Franck78/Chiplab/chiplab.pdf

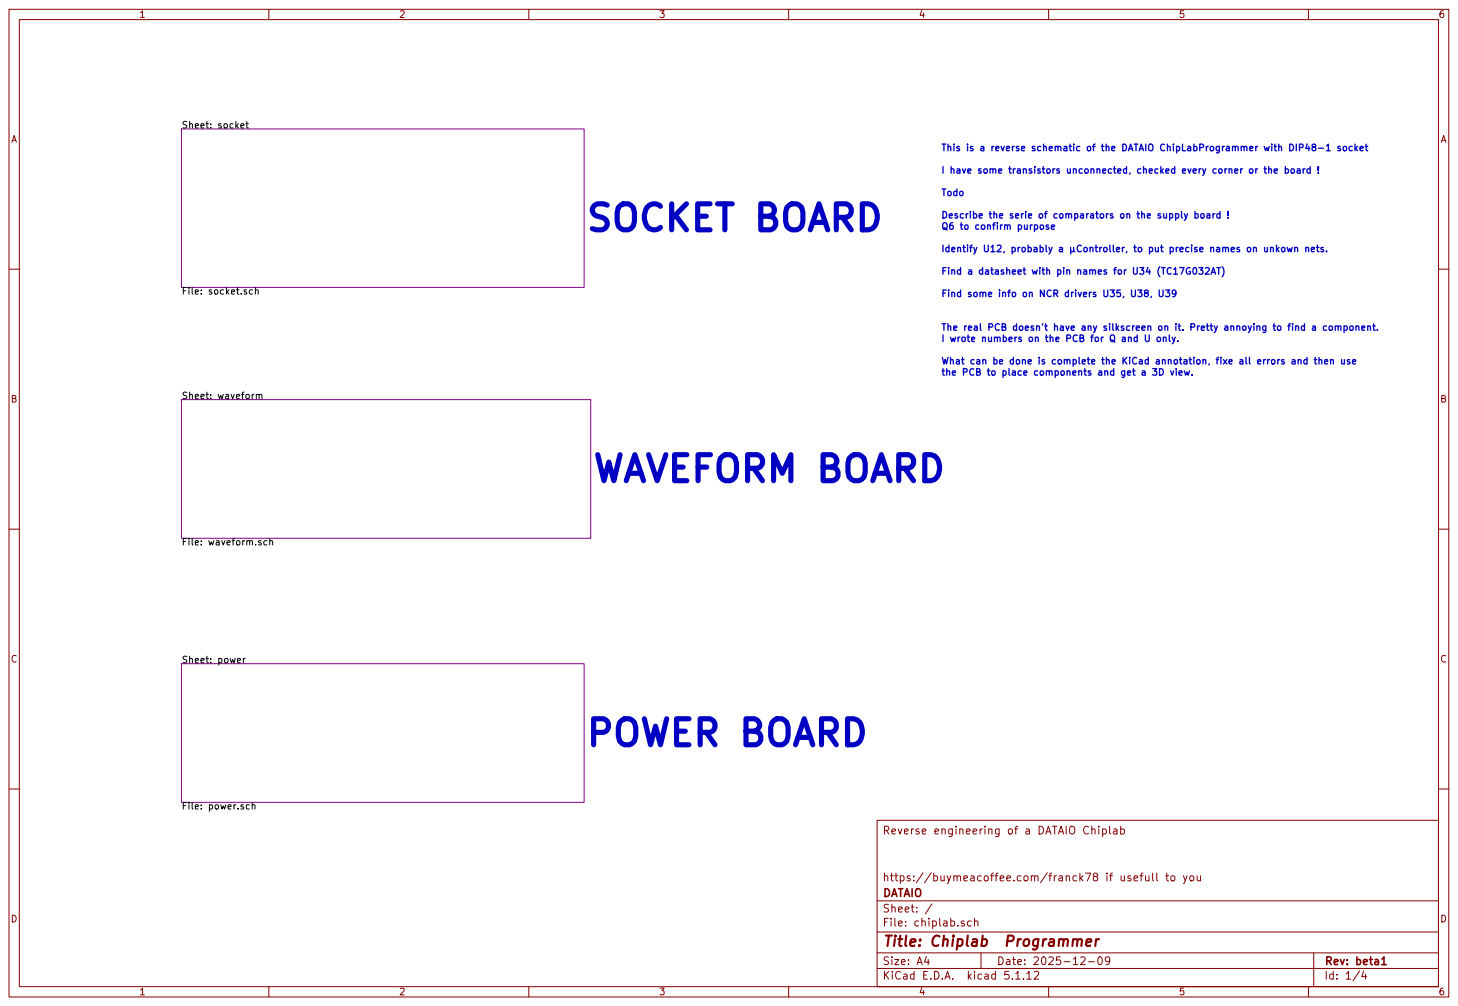
[picture p1: page 1]

Sheet: socket File: socket.sch Sheet: waveform

This is a reverse schematic of the DATAIO ChipLabProgrammer with DIP48-1 socket

I have some transistors unconnected, checked every corner or the board ! Todo Describe the serie of comparators on the supply board !

Identify U12, probably a µController, to put precise names on unkown nets.

Find a datasheet with pin names for U34 (TC17G032AT)

Find some info on NCR drivers U35, U38, U39

The real PCB doesn't have any silkscreen on it. Pretty annoying to find a component.
I wrote numbers on the PCB for Q and U only.

What can be done is complete the KiCad annotation, fixe all errors and then use
the PCB to place components and get a 3D view.

File: waveform.sch Sheet: power

Reverse engineering of a DATAIO Chiplab

https://buymeacoffee.com/franck78 if usefull to you
File: chiplab.sch Sheet: / DATAIO

Id: 1/4 Title: Chiplab Programmer

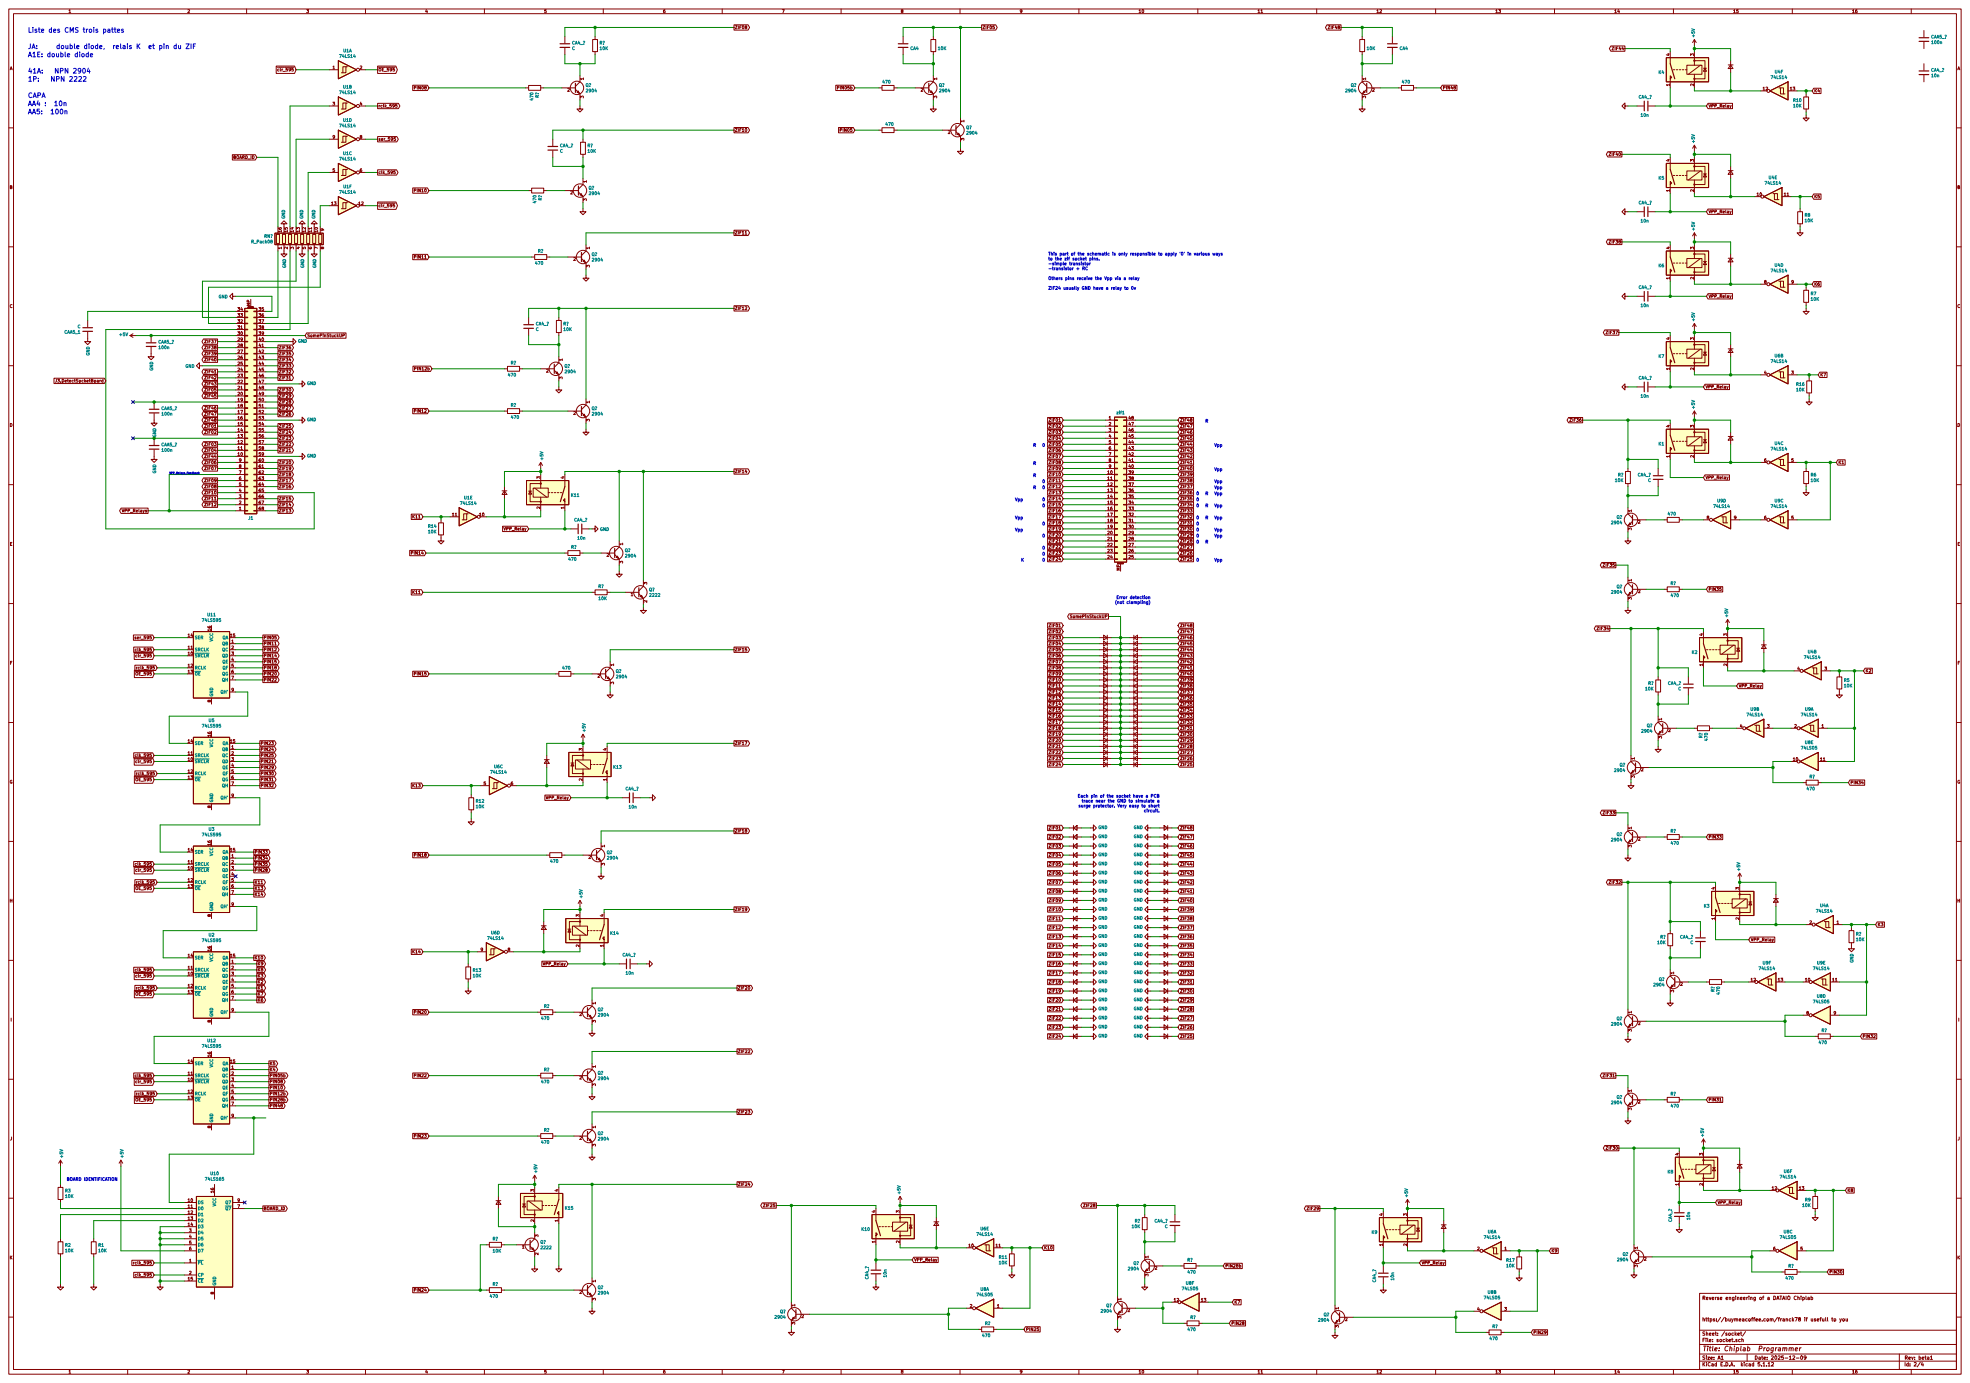
[picture p2: page 2]

Liste des CMS trois pattes

JA: double diode, relais K et pin du ZIF
A1E: double diode

This part of the schematic is only responsible to apply '0' in various ways
to the zif socket pins.
-simple transistor
-transistor + RC Others pins receive the Vpp via a relay

ZIF24 usually GND have a relay to 0v

74LS14 GND GND GND GND GND GND

surge protector. Very easy to short circuit. K

ZIF27
ZIF26
GND GND GND GND GND GND GND

Each pin of the socket have a PCB
trace near the GND to simulate a

Reverse engineering of a DATAIO Chiplab

Id: 2/4 Title: Chiplab Programmer File: socket.sch Sheet: /socket/ https://buymeacoffee.com/franck78 if usefull to you

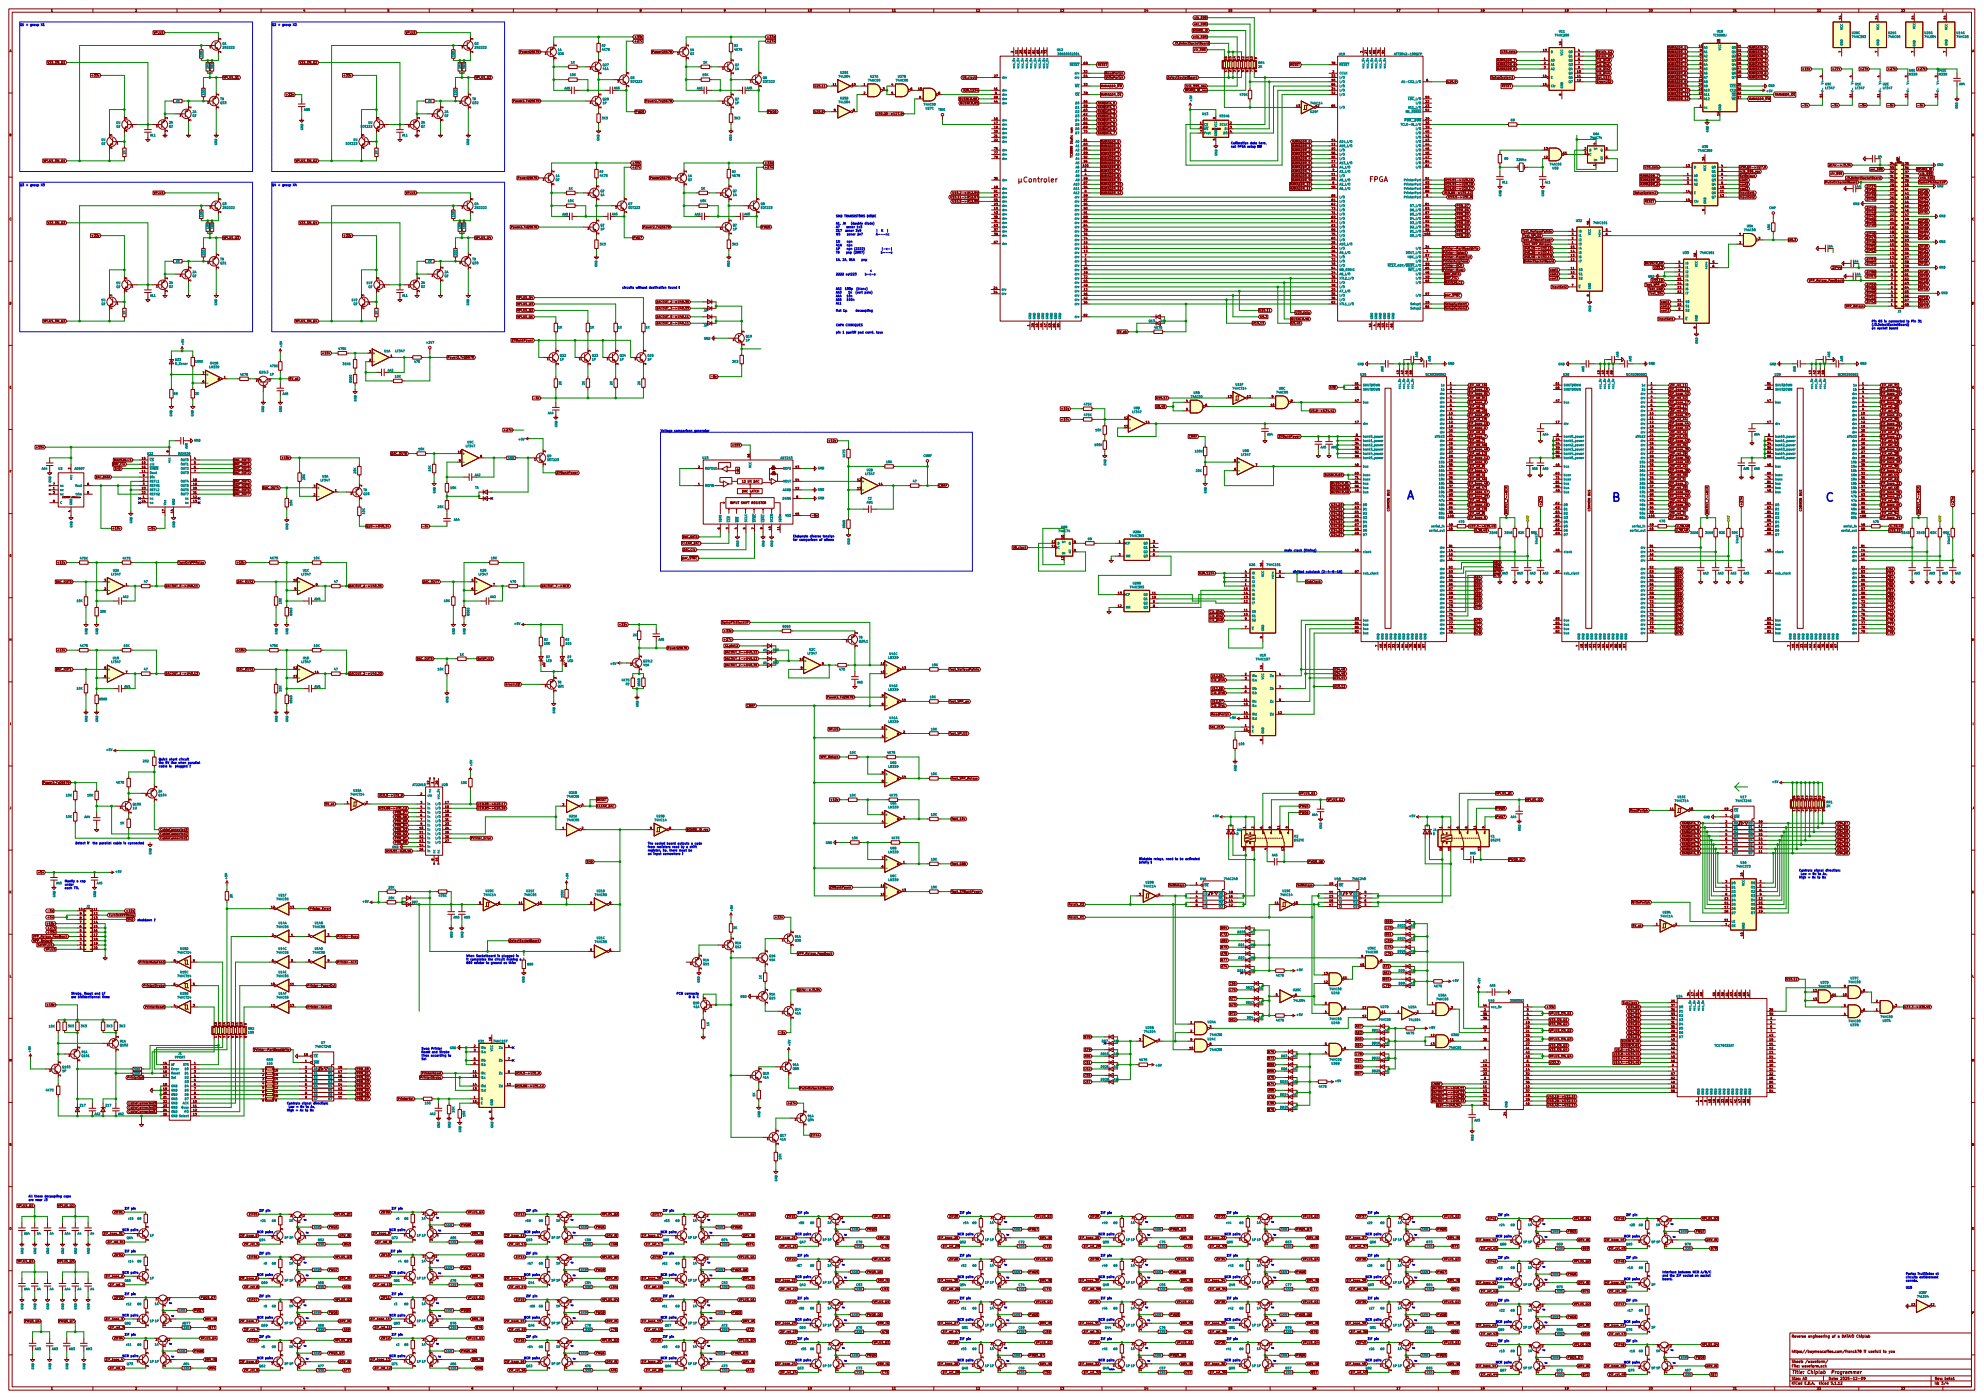
[picture p3: page 3]

Calibration data here, not FPGA setup !!!!

circuits without destination found !

flat 1µ decoupling CAPA CHIMIQUES

Pin 65 is connected to Pin 31
(J3.DetectSocketBoard) on socket board

pin 1 positif pad carré, tous

Elaborate diverse tension
for comparison of others

Quick short circuit
the 5V line when parallel
cable is plugged ?

Detect if the parallel cable is connected

The socket board outputs a code
from resistors read by a shift
register. So, there must be
an input somewhere !

Bistable relays, need to be activated
briefly !

Controls signal direction;
Low = Bx to Ax, High = Ax to Bx

When Socketboard is plugged in
it completes the circuit making a
660 reistor to ground as this:

Strobe, Reset and LF
are bididectionnal lines

Swap Printer Reset and Strobe

lines according to Sel

All these decoupling caps
are near J3

Interface between NCR A/B/C
and the ZIF socket on socket board.

Portes inutilisées et circuits entièrement sonnés. U15

Id: 3/4 Title: Chiplab Programmer File: waveform.sch Sheet: /waveform/ https://buymeacoffee.com/franck78 if usefull to you

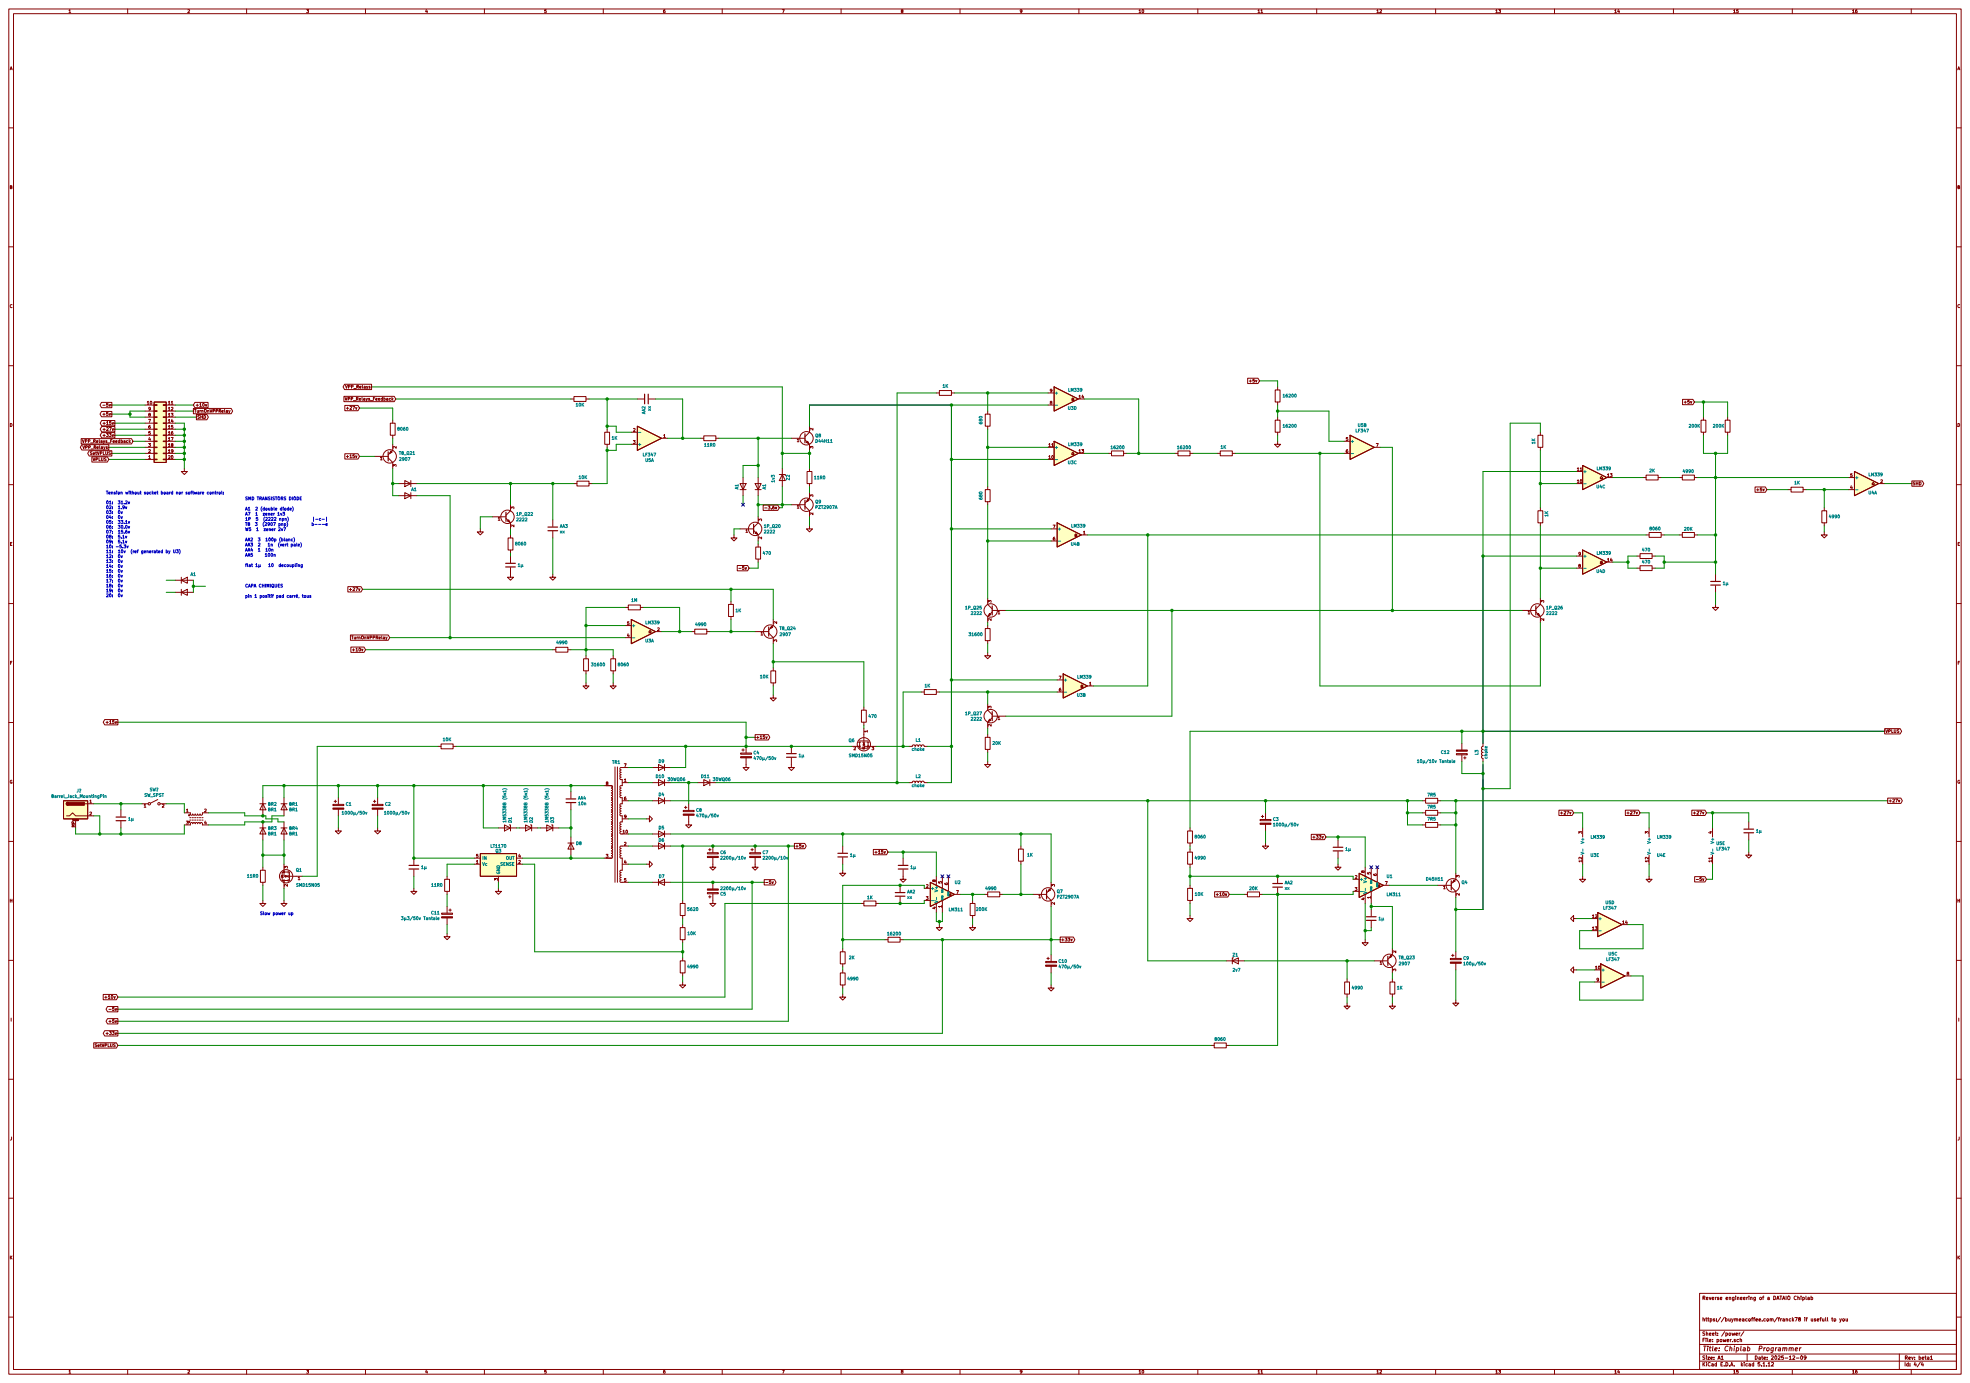
[picture p4: page 4]

Tension without socket board nor software control: 01: 31.2v 02: 1.9v 03: 0v 04: 0v 05: 33.1v 06: 30.0v 07: 15.6v 08: 5.1v 09: 5.1v 10: -5.3v 11: 10v (ref generated by U3) 12: 0v 13: 0v 14: 0v 15: 0v 16: 0v 17: 0v 18: 0v 19: 0v 20: 0v

SMD TRANSISTORS DIODE A1 2 (double diode) A7 1 zener 1v3

flat 1µ 10 decoupling CAPA CHIMIQUES

pin 1 positif pad carré, tous

https://buymeacoffee.com/franck78 if usefull to you

Sheet: /power/
File: power.sch
Id: 4/4 Title: Chiplab Programmer
