Franck78/Chiplab/power.sch

## KiCad design power.sch (2025-12-08)

Schematic: power.sch

Parts:
1P_Q20, 1P_Q22, 1P_Q25, 1P_Q26, 1P_Q27: 2222
A1: D
AA2, AA3: xx
AA4: 10n
BR1, BR2, BR3, BR4: BR1
C1, C2, C3: 1000µ/50v
C4, C8, C10: 470µ/50v
C5, C6, C7: 2200µ/10v
C9: 100µ/50v
C11: 3µ3/50v Tantale
C12: 10µ/10v Tantale
D1, D2, D3: 1N5338B (5v1)
D4, D5, D6, D7, D8, D9: D
D10, D11: 30WQ06
L1, L2, L3: choke
Q1, Q6: SMD15N05
Q3: LT1170
Q4: D45H11
Q7, Q9: PZT2907A; SOT-223-3_TabPin2
Q8: D44H11
T8_Q21, T8_Q23, T8_Q24: 2907
TR1: TR1
U1, U2: LM311
U3, U4: LM339
U5: LF347
Z1: 2v7
Z2: 1v3

Notes on the sheet:
Tension without socket board nor software control: 01: 31.2v 02: 1.9v 03: 0v 04: 0v 05: 33.1v 06: 30.0v 07: 15.6v 08: 5.1v 09: 5.1v 10: -5.3v 11: 10v (ref generated by U3) 12: 0v 13: 0v 14: 0v 15: 0v 16: 0v 17: 0v 18: 0v 19: 0v 20: 0v
SMD TRANSISTORS DIODE A1 2 (double diode) A7 1 zener 1v3 1P 5 (2222 npn) |-c-| T8 3 (2907 pnp) b---e W5 1 zener 2v7 AA2 3 100p (blanc) AA3 2 1n (vert pale) AA4 1 10n AA5 100n flat 1µ 10 decoupling CAPA CHIMIQUES pin 1 positif pad carré, tous
Slow power up
