Franck78/Chiplab/socket.sch

## KiCad design socket.sch (2025-12-08)

Schematic: socket.sch

Parts:
CAA5_1: C
J1: Conn_02x34_Counter_Clockwise_MountingPin
K1, K2, K3, K4, K5, K6, K7, K8, K9, K10, K11, K13, K14, K15: UMS05-1A80-75D; Relay_StandexMeder_UMS
R1, R2, R3, R5, R6, R7, R8, R9, R10, R11, R12, R13, R14, R16, R17: 10K
U1, U4, U6, U9: 74LS14
U2, U3, U5, U11, U12: 74LS595
U8: 74LS05
U10: 74LS165
zif1: Conn_02x24_Counter_Clockwise_MountingPin

Notes on the sheet:
BOARD IDENTIFICATION
Each pin of the socket have a PCB trace near the GND to simulate a surge protector. Very easy to short circuit.
Liste des CMS trois pattes JA: double diode, relais K et pin du ZIF A1E: double diode 41A: NPN 2904 1P: NPN 2222 CAPA AA4 : 10n AA5: 100n
VPP_Relays_Feedback
This part of the schematic is only responsible to apply '0' in various ways to the zif socket pins. -simple transistor -transistor + RC Others pins receive the Vpp via a relay ZIF24 usually GND have a relay to 0v
Error detection (not clampling)
Vpp
