Franck78/Chiplab/waveform.sch

## KiCad design waveform.sch (2025-12-08)

Schematic: waveform.sch

Parts:
1U: Q?
A54, A55, A56, A57, A58, A59, A72, A73, A76, A77, A78, A79: 330
AB77: 330
B52, B53, B54, B55, B56, B57, B58, B59, B72, B73, B74, B75, B76, B78, B79: 330
C52, C53, C54, C55, C56, C57, C58, C59, C72, C73, C74, C75, C76, C77, C78, C79: 330
DD1, DD2, DD3, DD4, DD5, DD6, DD7, DD8, DD10, DD11, DD12, DD13, DD14, DD15, DD16, DD21, DD22, DD23, DD24, DD25, DD26, DD27, DD28, DD29, DD30: A1
DZ3: D_Zener
J1: PPORT
J2: Conn_02x10_Counter_Clockwise
J3: Conn_02x34_Counter_Clockwise_MountingPin
JA: D
K1, K2: DS2YE; Relay_DPDT_FRT5
Q1, Q2, Q3, Q4: 2N2222
Q5, Q6, Q7, Q8, Q9: SOT223
Q10, Q14, Q16, Q17, Q18, Q27, Q29.2: 41A
Q11, Q12, Q15, Q34, Q35, Q99, Q101, Q102: 91A
Q13: A1
Q19, Q22, Q23, Q24, Q25, Q28, Q29.3, Q40, Q41, Q42, Q43, Q44, Q45, Q46, Q47, Q48, Q49, Q50, Q51, Q52, Q53, Q54, Q55, Q60, Q61, Q62, Q63, Q64, Q65, Q66, Q67, Q68, Q69, Q70, Q71, Q72, Q73, Q74, Q75, Q80, Q81, Q82, Q83, Q84, Q85, Q86, Q87, Q88, Q89, Q90, Q91, Q92, Q93, Q94, Q95, Q103: 1P
Q20, Q21, Q29.1, Q30, Q31, Q32, Q33: T8
Q26: 1A
Q104: 2A
Q105: 1U
RR1, RR4: 2K
RR2, RR3: 100
U1, U2, U9: LF347
U3: AD587
U4: 74AC240
U5: 74AC00
U6: 74AC74
U7, U17: 74HCT245
U8, U41: LM339
U10, U31: 74HC157
U11, U30: 74HC259
U12: 30800002001
U13: 93S46
U14, U21: 74HC05
U15: 74HCT14
U16: 74HC373
U18: TC5588J; DIP-28_W15.24mm
U19: ATT3042-100QFP
U20: AT22V10
U22: MAX528
U23: AD7243
U24, U27, U36, U37: 74HC00
U25: 74LS04
U26, U32, U33: 74HC151
U28: 74HC393
U29: 74HC14
U34: TC17G032AT
U35, U38, U39: NCR0390582
U40: 3080092
black: 50K
r2, r3, r4, r5, r6, r8, r9, r10, r11, r12, r14, r15, r16, r17, r18, r20, r21, r22, r23, r24, r26, r27, r28, r29, r41, r42, r43, r44, r45, r46, r48, r49, r50, r51, r52, r54, r55, r56, r57, r58, r60, r61, r62, r63, r64, r66, r67, r68: 68

Notes on the sheet:
Portes inutilisées et circuits entièrement sonnés. U15
SMD TRANSISTORS DIODE A1, JA (double diode) A7 zener 1v3 Z17 zener 3v9 | K | W5 zener 2v7 A---nc 1U npn 41A npn 1P npn (2222) |-c-| T8 pnp (2907) b---e 1A, 2A, 91A pnp c 2222 sot223 b-c-e AA2 100p (blanc) AA3 1n (vert pale) AA4 10n AA5 100n AL1 flat 1µ decoupling CAPA CHIMIQUES pin 1 positif pad ca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
Controls signal direction; Low = Bx to Ax, High = Ax to Bx
NCR pairs
ZIF pin
top
bottom
Q1 + group X1
Q2 + group X2
Q3 + group X3
Q4 + group X4
Swap Printer Reset and Strobe lines according to Sel
main clock (timing)
divided subclock (2-4-8-16)
Elaborate diverse tension for comparison of others
circuits without destination found !
Bistable relays, need to be activated briefly !
Pin 65 is connected to Pin 31 (J3.DetectSocketBoard) on socket board
When Socketboard is plugged in it completes the circuit making a 660 reistor to ground as this:
PCB connects B & C
Voltage comparison generator
Strobe, Reset and LF are bididectionnal lines
Detect if the parallel cable is connected
Quick short circuit the 5V line when parallel cable is plugged ?
Interface between NCR A/B/C and the ZIF socket on socket board.
All these decoupling caps are near J3
Mostly a cap under each TTL
The socket board outputs a code from resistors read by a shift register. So, there must be an input somewhere !
shutdown ?
Calibration data here, not FPGA setup !!!!
