Franck78/Chiplab/(commit log)

2025-12-07 Add files via upload
    Version 0, need some work
    [chiplab.sch, power.sch, socket.sch, waveform.sch]
2025-12-08 Add files via upload
    A lot of corrections everywhere.
    [chiplab.sch, power.sch, socket.sch, waveform.sch]
